malismf/iot_musorka/binsense/README.md

# BinSense — мониторинг заполненности мусорных контейнеров

Датчик на ESP8266 (NodeMCU) живёт под крышкой контейнера, измеряет уровень
мусора ультразвуком раз в 15 минут и отправляет данные по MQTT, когда уровень
изменился. Диспетчер видит контейнеры на карте, получает уведомления в
веб-приложении, когда пора вывозить, и может посмотреть историю
заполнения.
Питание — от USB (зарядка телефона 5 В), устройство работает постоянно.

```
  устройство (ESP8266 + УЗ-датчик)
        │ MQTT (QoS 1, retained-настройки)
        ▼
    Mosquitto ──► ingestor ──► PostgreSQL ──► Grafana (мониторинг разработчика)
                                    ▲
                                    │ SQL + LISTEN/NOTIFY
                                    ▼
                                  FastAPI ──REST/WebSocket──► веб-приложение (карта, события)
```

## Быстрый старт

```bash
git clone https://github.com/ВАША_КОМАНДА/binsense.git
cd binsense
./infra/scripts/init-env.sh bins.example.com admin@bins.example.com
docker compose up -d --build

# посмотреть, как всё работает, без единого устройства:
docker compose --profile demo up -d emulator
```

Откройте `https://bins.example.com` и войдите под администратором, пароль
напечатал `init-env.sh`. Подробная инструкция по развёртыванию —
[docs/DEPLOY.md](docs/DEPLOY.md), проверка на ноутбуке с настоящей платой по
Wi-Fi — [docs/LOCAL_TEST.md](docs/LOCAL_TEST.md).

## Документация

| Файл | О чём |
|---|---|
| [docs/DEPLOY.md](docs/DEPLOY.md) | развёртывание сервера с нуля, обновления, бэкапы, устранение неполадок |
| [docs/LOCAL_TEST.md](docs/LOCAL_TEST.md) | локальный стенд: сервер на ноутбуке, плата по Wi-Fi |
| [docs/ASSEMBLY.md](docs/ASSEMBLY.md) | сборка устройства своими руками: от макета до установки на контейнер |
| [docs/USER_GUIDE.md](docs/USER_GUIDE.md) | инструкции монтажнику, диспетчеру и водителю |
| [docs/FIRMWARE.md](docs/FIRMWARE.md) | устройство прошивки, консоль, энергопотребление |
| [docs/PROTOCOL.md](docs/PROTOCOL.md) | MQTT, REST, WebSocket, интерфейсы периферии |
| [docs/asyncapi.yaml](docs/asyncapi.yaml) | формальное описание MQTT-протокола (AsyncAPI) |
| [docs/openapi.json](docs/openapi.json) | схема REST API (живая версия — `/api/docs`) |
| [docs/TESTING.md](docs/TESTING.md) | тесты прошивки и сервера, проверка системы целиком |
| [docs/REQUIREMENTS.md](docs/REQUIREMENTS.md) | соответствие требованиям задания и разделение работы |
| [CLAUDE.md](CLAUDE.md) | краткий контекст проекта: решения, инварианты, соглашения (его же читает Claude Code) |
| [hardware/WIRING.md](hardware/WIRING.md) | схема подключения и пояснения к обвязке |
| [docs/MEDIA.md](docs/MEDIA.md) | что снять для отчёта: список кадров и сценарий видео |
| [docs/presentation/](docs/presentation/) | презентация: структура, тезисы, ожидаемые вопросы (слайды опубликованы отдельно) |

## Состав репозитория

```
binsense/
├── firmware/      прошивка ESP8266 (PlatformIO) + тесты логики на хосте
├── backend/       FastAPI, ingestor, миграции, тесты
├── frontend/      веб-приложение (React, Leaflet, Chart.js)
├── tools/         provision.py (подготовка устройств), emulator.py
├── infra/         docker-compose, Mosquitto, Caddy, Grafana, скрипты
├── hardware/      спецификация и схема подключения
└── docs/          документация, тезисы презентации, план съёмки
```

## Возможности

**Устройство**
- ультразвуковой датчик по UART, медиана из нескольких замеров;
- питание от USB: постоянная связь с брокером, настройки применяются сразу;
- отправка только при изменении уровня или по heartbeat;
- калибровка одной кнопкой, индикация светодиодом и зуммером;
- настройка Wi-Fi через портал, учётные данные — без перепрошивки.

**Сервер**
- у каждого устройства своя учётная запись MQTT и доступ только к своим топикам;
- правила: заполнен, срочно вывезти, вывезен, нет связи, сбой датчика;
- история телеметрии с агрегацией, журнал действий;
- Grafana с техническими метриками: потери, задержки, время подключения, RSSI.

**Приложение**
- карта с цветными метками и живыми обновлениями по WebSocket;
- карточка контейнера: график за сутки, события, настройки;
- лента событий: предупреждения всплывают на любой странице;
- добавление устройства по коду привязки (ссылкой или вручную) с выбором места на карте;
- один уровень доступа: любой пользователь — администратор.

## Разработка

```bash
# сервер и база в Docker, фронтенд отдельно с горячей перезагрузкой
docker compose -f docker-compose.yml -f docker-compose.dev.yml up -d --build
cd frontend && npm install && npm run dev

# тесты
cd backend && python -m pytest
cd firmware/hosttest && ./run.sh
```

Лицензия: MIT.
