malismf/iot_musorka/binsense/docs/REQUIREMENTS.md

# Соответствие требованиям задания

| № | Требование | Как закрыто | Где смотреть |
|---|---|---|---|
| 1 | Электрическая схема: принципиальная и монтажная, со всеми обвязочными элементами | **В работе:** схемы команда рисует сама по таблице распиновки и спецификации | `hardware/WIRING.md`, `hardware/BOM.csv` |
| 2 | Способы взаимодействия периферии и МК | UART (ультразвуковой датчик, программный), цифровой вход (кнопка), длительность импульса (HC-SR04), ШИМ (RGB-светодиод), цифровой выход через транзистор (зуммер), Wi-Fi | `docs/PROTOCOL.md` §4, `firmware/src/` |
| 3 | Взаимодействие модулей системы | MQTT между устройством и сервером, REST + WebSocket между сервером и приложением, PostgreSQL LISTEN/NOTIFY между сервисами | `docs/PROTOCOL.md`, `docs/asyncapi.yaml` |
| 4 | Модель корпуса, отдельные STL, схема расположения элементов | **Не закрыто:** 3D-модели корпуса в проекте нет, корпус — готовая герметичная коробка. Расположение деталей будет показано на монтажной схеме, которую рисует команда | `docs/ASSEMBLY.md` §7 |
| 5 | Описание проекта, презентация, репозиторий, документация API и протоколов | Репозиторий с документацией; OpenAPI генерируется автоматически, MQTT описан в AsyncAPI; презентация на 19 слайдов с тезисами и разбором ожидаемых вопросов | `README.md`, `docs/presentation/`, `docs/openapi.json`, `/api/docs`, `docs/asyncapi.yaml` |
| 6 | Первое включение, настройка, калибровка, регистрация (PlugAndPlay) | Портал Wi-Fi без прошивки, привязка по коду (ссылкой из `provision.py` или вводом вручную), калибровка одной кнопкой; «заводская» подготовка скриптом | `docs/USER_GUIDE.md`, `tools/provision.py`, `docs/LOCAL_TEST.md` |
| 7 | Сценарии использования с реакцией устройства на действия | Роли монтажника, диспетчера и водителя; таблица индикации: цвет светодиода и сигналы зуммера на каждое действие | `docs/USER_GUIDE.md`, `docs/FIRMWARE.md` (раздел «Индикация») |
| 8 | Приложение с картой, данными в реальном времени и историей | React-приложение: карта Leaflet с цветными метками, список, карточка с графиком за сутки, живые обновления по WebSocket | `frontend/` |
| 9 | Сервер обмена данными | Mosquitto с авторизацией и разграничением доступа по устройствам | `infra/mosquitto/`, `backend/app/mqtt.py` |
| 10 | Регистрация устройств, связь пользователя и устройства | Код привязки (хранится хешем), привязка по ссылке или вводом кода, блокировка перебора, удаление устройства | `backend/app/api/routes/devices.py`, `backend/app/devices.py` |
| 11 | База данных: история, пользователи, действия | PostgreSQL: `users`, `devices`, `device_config`, `telemetry`, `events`, `audit_log`, `device_metrics`, `api_requests` | `backend/migrations/001_init.sql` |
| 12 | (опционально) Сервер логов и мониторинга для разработчика | Grafana: доступность устройств, потери сообщений, задержка доставки, время подключения, RSSI, время ответа API, причины перезагрузок, часы простоя | `infra/grafana/`, `/grafana/` |
| 13 | Обратная связь, когда пользователь не рядом с устройством | Веб-приложение (открывается и с телефона): события приходят в реальном времени по WebSocket, предупреждения всплывают на любой странице, лента событий с кнопкой «Принято», повторное срочное событие, если заполненный контейнер не подтвердили за 2 часа | `frontend/src/lib/store.jsx`, `frontend/src/pages/EventsPage.jsx`, `backend/app/rules.py` |

## Разделение работы в команде

| Участник | Зона ответственности | Файлы |
|---|---|---|
| A — электроника и прошивка | схемы, сборка, пайка, прошивка, энергопотребление, заводская подготовка устройств | `firmware/`, `hardware/`, `tools/provision.py` |
| B — бэкенд | брокер, API, база, правила событий, развёртывание, эмулятор, Grafana | `backend/`, `infra/`, `tools/emulator.py` |
| C — дизайн и фронтенд | интерфейс, карта, фотографии, видео, презентация | `frontend/`, `docs/presentation/`, `docs/MEDIA.md` |

## Что осталось физически

Всё, что можно сделать без собранного устройства, сделано. Остаются работы,
которые требуют железа в руках:

- собрать устройство на реальной плате ESP8266 и проверить датчик на контейнере;
- отснять фотографии и видео по списку в `docs/MEDIA.md`;
- проверить сборку docker-образов на машине с доступом к реестру;
- пройти сквозную проверку на локальном стенде: сервер на ноутбуке, плата по
  Wi-Fi (`docs/LOCAL_TEST.md`).

## Что стоит показать в презентации как «путь проб»

- HC-SR04 на макете → влагозащищённый датчик по UART (питание 5 В, влага,
  ширина луча, другой протокол);
- ESP32 с аккумулятором и глубоким сном → ESP8266 (NodeMCU) с питанием от
  USB: такая плата была в наличии, а без батареи устройство работает
  постоянно — кнопка и настройки срабатывают сразу;
- PubSubClient → arduino-mqtt: понадобился QoS 1, чтобы устройство знало, что
  данные дошли;
- отправка каждые 15 минут → отправка по изменению: в базе только изменения;
- замер при открытой крышке → геркон на крышке → геркона в комплекте нет:
  резкий скачок уровня перепроверяется повторным замером через минуту;
- ArduinoJson → свой разбор JSON: меньше памяти и тесты логики гоняются на
  обычном компьютере, пока железо едет;
