malismf/iot_musorka/binsense/docs/presentation/README.md

# Презентация

Девятнадцать слайдов на защиту, примерно на 10–11 минут. Презентация
опубликована как отдельный документ и правится там же; здесь лежит её
содержание в текстовом виде — чтобы можно было готовиться без интернета,
пересобрать в PowerPoint или отдать другому докладчику.

Принципиальную и монтажную схемы команда рисует сама по `hardware/WIRING.md`.
Диаграмма архитектуры, цикл работы устройства и схема стенда для защиты
нарисованы прямо в слайдах.

Фотографии и видео добавляются по мере съёмки — сценарий в
[../MEDIA.md](../MEDIA.md).

---

## Структура

| № | Слайд | О чём | Что на экране |
|---|---|---|---|
| 1 | BinSense | название, одна фраза о проекте | три цифры: полгода от 18650, 107 тестов, 3 человека |
| 2 | Проблема | расписание промахивается в обе стороны | пустые рейсы / переполнение / нет данных |
| 3 | Решение | устройство молчит, пока нечего сказать | цикл из пяти шагов |
| 4 | Архитектура | пять сервисов и одна база | диаграмма обмена данными |
| 5 | Устройство | что внутри и почему именно так | таблица узлов + цифры по току |
| 6 | Принципиальная схема | вся обвязка | схема целиком |
| 7 | Решения в схеме | ключ, кнопка на RTC-выводе, ADC1 | три карточки |
| 8 | Монтажная схема | что куда паяется | схема шилда |
| 9 | Энергопотребление | откуда берётся полгода | таблица токов + расчёт |
| 10 | Протокол | рассчитан на спящее устройство | retained, QoS 1, без Last Will |
| 11 | Приложение | что видит диспетчер | шесть карточек |
| 12 | Telegram | обратная связь вне рабочего места | уведомления, кнопка, команды |
| 13 | Plug and Play | первое включение без компьютера | три шага |
| 14 | Стенд для защиты | всё на одном ноутбуке | схема «ESP32 → хот-спот → Docker → браузер» и три карточки |
| 15 | Мониторинг | что видит разработчик | таблица панелей Grafana |
| 16 | Путь проб | что выкинули и почему | таблица «было → стало → почему» |
| 17 | Состояние | что проверено, что нет | два столбца |
| 18 | Команда | роли и планы | шесть карточек |
| 19 | Финал | вывоз по факту, а не по расписанию | заключение |

---

## Тезисы докладчика

**1. BinSense.** Система мониторинга заполненности мусорных контейнеров.
Датчик на ESP32 живёт под крышкой контейнера и работает от одного
аккумулятора около полугода.

**2. Проблема.** Расписание не знает, что происходит во дворе. Отсюда две
ошибки сразу: лишние рейсы к пустым контейнерам и переполнение там, где людей
много.

**3. Решение.** Цикл устройства: проснуться по таймеру или кнопке, померить,
решить, нужно ли отправлять, отправить и уснуть. Отправка по изменению, а не
по таймеру, — главное решение по энергопотреблению. Резкий скачок уровня
плата сначала перемеряет через минуту: датчика крышки нет, и замер мог
попасть на открытую крышку.

**4. Архитектура.** Брокер, приёмник данных, база, API, бот и Grafana. Всё
поднимается одной командой `docker compose up`. Реальное время сделано без
Redis: ingestor делает `pg_notify`, API слушает канал и рассылает по WebSocket.

**5. Устройство.** Ключевые детали — плата с малым током сна и ключ питания
датчика. Без ключа датчик ест миллиамперы круглосуточно. Замер — медиана из
семи, скачок на 20 % и больше перепроверяется повторным замером.

**6. Принципиальная схема.** Вся обвязка на месте: подтяжки, делители, ключи,
конденсаторы. Схема генерируется из той же таблицы распиновки, что и
документация, — править нужно один список, а не три картинки.

**7. Решения в схеме.** Ключ питания датчика: в покое датчик ест несколько
миллиампер, в тысячи раз больше, чем ESP32 во сне. Кнопка на RTC-выводе
GPIO32 будит ESP32 из глубокого сна, 10 кОм и 100 нФ убирают дребезг.
Батарея на GPIO35: ADC2 не работает при включённом Wi-Fi.

**8. Монтажная схема.** По ней собирают, а не по принципиальной. Ключ Q1
и конденсатор C1 стоят рядом, чтобы питание датчика не проседало. Провода
датчика идут в клеммник: разъём Dupont в контейнере разбалтывается от
вибрации.

**9. Энергопотребление.** Цикл: пробуждение на 3 секунды при 120 мА — около
0.1 мА·ч; при интервале 15 минут примерно 10 мА·ч в сутки. Аккумулятор
2500 мА·ч даёт около полугода. С обычным DevKit та же батарея сядет за
две–три недели.

**10. Протокол.** Настройки — retained-сообщение: спящее устройство не примет
команду в произвольный момент. QoS 1 и дедупликация по устройству,
идентификатору включения и номеру пакета. Last Will не используется: для
спящего устройства брокер объявлял бы офлайн после каждого засыпания.

**11. Приложение.** Карта с цветными метками, карточка с графиками,
маршрут вывоза, привязка по коду.

**12. Telegram.** Уведомление в момент события и подтверждение одной кнопкой.
Это закрывает требование об обратной связи, когда пользователь не рядом с
устройством.

**13. Plug and Play.** Портал Wi-Fi без прошивки, привязка по коду (ссылка
из скрипта подготовки или ручной ввод), калибровка одной кнопкой. «Заводская»
подготовка — скриптом.

**14. Стенд для защиты.** Систему показываем целиком на одном ноутбуке:
он раздаёт плате Wi-Fi хот-спотом (адрес по умолчанию 192.168.137.1) и держит
весь сервер в Docker. provision.py прошивает плату, записывает адрес брокера
и выдаёт ссылку для привязки. Без интернета не будет только плиток карты и
Telegram. Инструкция — `docs/LOCAL_TEST.md`.

**15. Мониторинг.** Доступность, потери сообщений, задержка доставки, время
бодрствования, заряд, причины перезагрузок. Без этого не видно, что устройство
начало просыпаться чаще, чем должно.

**16. Путь проб.** Восемь строк — почти каждая стоила дня работы. Показываем
их специально: конечная конструкция без них выглядит как удача.

**17. Состояние.** Честно разделяем: прогнано на стенде — подготовка
устройства, привязка, телеметрия, события, уведомления, история,
маршрут, 38 тестов сервера и 51 проверка логики прошивки. Не проверено вживую
— сборка docker-образов, реальный ESP32 на стенде «ноутбук + Wi-Fi»,
реальный Telegram Bot API.

**18. Команда.** Роли разделены по каталогам репозитория, поэтому работа шла
параллельно. Дальше: устройство на реальной плате и стенд целиком, съёмка,
месяц на реальных контейнерах.

**19. Финал.** Вывоз по факту, а не по расписанию.

---

## Вопросы, которые зададут

| Вопрос | Короткий ответ |
|---|---|
| Почему не LoRaWAN или NB-IoT? | Wi-Fi во дворе есть у управляющей компании, а модуль дешевле и не требует оператора. Протокол вынесен в отдельный модуль прошивки: замена транспорта не трогает логику. |
| Что будет зимой? | Датчик влагозащищён, корпус герметичный, внутри силикагель. Ёмкость Li-ion на морозе падает — это честное ограничение, в Grafana видно по напряжению. |
| Как считается процент? | По расстоянию до мусора: пустой уровень задаётся калибровкой. Формула одна и та же в прошивке и на сервере — иначе устройство и карточка разойдутся. |
| Что, если мусор лежит горкой? | Ультразвук меряет ближайшую точку, поэтому процент завышается. Берём медиану нескольких замеров, а резкий скачок (например, крышку открыли во время замера) перепроверяем повторным замером через минуту. |
| Почему нет датчика крышки? | Геркона нет в комплекте. Устройство меряет по таймеру, а если замер попал на открытую крышку (рука или небо в луче), резкий скачок уровня перепроверяется повторным замером через минуту — случайное значение до сервера не доходит. |
| Почему привязка не по QR? | Печатать наклейки нам негде. Скрипт подготовки выдаёт ссылку с кодом: она открывает форму привязки с уже заполненными полями, код можно ввести и вручную. Код хранится хешем, перебор блокируется. |
| Что покажете вживую? | Всё на одном ноутбуке: хот-спот для платы, сервер в Docker, приложение в браузере. Домен и интернет не нужны. |
| Украдут? | В системе устройство привязано к учётной записи, удаление пишется в журнал. Сигнализацию не делали. |
| Сколько стоит устройство? | Смета — `hardware/BOM.csv`, 24 позиции; основные деньги — плата, датчик и аккумулятор. |
| Почему не KiCad? | Схема генерируется из той же таблицы распиновки, что и документация. Это исключает расхождение между схемой, прошивкой и описанием — при ручном проекте оно возникает на первой же правке пинов. |
