malismf/iot_musorka/binsense/docs/MEDIA.md

# Фото и видео: что снять и как

Съёмку делает человек с собранным устройством — заменить её нечем. Этот файл
закрывает подготовительную часть: что именно должно попасть в кадр, в каком
порядке и какой длины. По нему съёмка занимает один вечер вместо трёх
подходов.

Готовые материалы кладутся в `docs/media/` и подключаются в презентацию
(`docs/presentation/`) и в `README.md`.

---

## Оборудование

Телефон на штативе или стопке книг, настольная лампа с листом бумаги вместо
рассеивателя, лист серого или белого картона фоном. Съёмка с рук даёт дрожь,
которая на проекторе заметнее, чем на экране телефона.

Видео — 1080p 30 кадров, горизонтально. Вертикальное видео на защите
показывать неудобно.

---

## Фотографии

Список ниже — минимальный набор, который закрывает отчёт и презентацию.

| № | Кадр | Зачем | Как снимать |
|---|---|---|---|
| 1 | Компоненты, разложенные по местам | открывающий слайд, «из чего собрано» | вид сверху, фон-картон, подписи добавляются в презентации |
| 2 | Макет на breadboard с HC-SR04 | слайд «путь проб»: с чего начинали | общий план, видно провода и делитель Echo |
| 3 | Макетная плата с напаянной обвязкой, крупно | доказательство, что паяли сами | макро, фокус на резисторах и ключе зуммера |
| 4 | Плата в корпусе до закрытия крышки | компоновка и укладка проводов | сверху, при ровном свете |
| 5 | Устройство в сборе, три четверти | главное фото проекта | на сером фоне, свет сбоку |
| 6 | Устройство под крышкой контейнера | как ставится | с руками в кадре: масштаб понятнее |
| 7 | Устройство на контейнере, снизу | рабочее положение датчика | снизу вверх, видно головку датчика |
| 8 | Консоль платы: подключение к Wi-Fi и брокеру | видно, что устройство на связи | снимок экрана монитора порта |
| 9 | Страница «Добавить устройство» с заполненным кодом | привязка устройства | экран ноутбука или телефона; код привязки замажьте |
| 10 | Экран телефона с картой | приложение | снять экран, а не скриншот: видно, что это реальная система |
| 11 | Всплывающее предупреждение и лента событий в приложении | обратная связь | снять экран телефона |

Скриншоты интерфейса и Grafana делаются отдельно, в браузере: `Ctrl+Shift+S`
в Firefox снимает страницу целиком без обрезки.

---

## Видео: сценарий на 2:30

Один дубль на сцену, монтаж встык. Закадровый голос пишется отдельно и
кладётся поверх — синхронно говорить и снимать не получается.

| Время | Что в кадре | Закадровый текст |
|---|---|---|
| 0:00–0:12 | контейнер во дворе, крышка открывается | «Мусоровоз ездит по расписанию. Половина контейнеров пустые, часть переполнена ещё вчера.» |
| 0:12–0:25 | устройство в руках, потом на крышке | «Устройство измеряет уровень ультразвуком и работает от обычной USB-зарядки.» |
| 0:25–0:45 | подача питания, светодиод, портал Wi-Fi на телефоне | «Первое включение: устройство поднимает точку доступа, вводим сеть — прошивать ничего не нужно.» |
| 0:45–1:05 | ссылка для привязки, форма в приложении, карточка | «Привязка по коду: открываем ссылку, отмечаем место на карте — устройство появляется на карте.» |
| 1:05–1:25 | калибровка кнопкой: пустой контейнер, затем набросать мусор | «Калибровка одной кнопкой по пустому контейнеру. Дальше устройство считает процент само.» |
| 1:25–1:45 | заполнение контейнера, метка на карте меняет цвет | «Данные уходят по MQTT. Метка на карте меняет цвет по мере заполнения.» |
| 1:45–2:05 | предупреждение всплывает в приложении и появляется в ленте событий | «На 80 % приложение сразу показывает уведомление о заполненном контейнере.» |
| 2:05–2:20 | график истории в карточке | «История показывает, как заполнялся контейнер, — видно, когда его вывезли.» |
| 2:20–2:30 | общий план, логотип | «BinSense. Вывоз по факту, а не по расписанию.» |

Съёмочные хитрости:

- контейнер заполняется пустыми коробками — они лёгкие и не пачкают кадр;
- чтобы не ждать 15 минут между отправками, на время съёмки уменьшите
  `heartbeat_s` в настройках устройства через приложение;
- сцены 1:25–1:45 и 1:45–2:05 снимаются подряд одним заходом, иначе состояние
  системы придётся откатывать;
- телефон в кадре должен быть в режиме «не беспокоить»: чужие уведомления
  придётся вырезать.

---

## Схемы

Принципиальную и монтажную схемы команда рисует сама по `hardware/WIRING.md`.
Снимать их не нужно — в презентацию идут готовые рисунки.
