malismf/iot_musorka/BinSense.pptx

КУРСОВОЙ ПРОЕКТ · ИНТЕРНЕТ ВЕЩЕЙ

BinSense

Мусорные контейнеры сами сообщают, когда их пора вывозить

≈ 6 месяцев

работы от одного аккумулятора 18650

99 тестов

48 на сервере, 51 на логике прошивки

3 человека

электроника, сервер, интерфейс и корпус

Notes: Здравствуйте. Проект BinSense: система мониторинга заполненности мусорных контейнеров. Датчик на ESP32 живёт под крышкой контейнера и работает от одного аккумулятора около полугода.

## Slide 2

Вывоз по расписанию промахивается в обе стороны

Пустые рейсы

Мусоровоз объезжает контейнеры, до которых ещё неделя. Топливо и время водителя уходят впустую.

Переполнение

Контейнер во дворе с высокой проходимостью переполняется за два дня, а по графику его вывезут в пятницу.

Нет данных

Диспетчер не знает, что происходит во дворах, пока не позвонят жильцы. Планировать не на чем.

Проблема

2

Notes: Расписание не знает, что происходит во дворе. Отсюда две ошибки сразу: лишние рейсы и переполненные контейнеры.

## Slide 3

Устройство измеряет уровень и молчит, пока нечего сказать

Ультразвуковой датчик под крышкой контейнера меряет расстояние до мусора. Данные уходят по MQTT только когда заполненность изменилась заметно — это главная экономия батареи.

Интервал опроса и порог изменения задаются с сервера и меняются без перепрошивки.

Решение

3

Notes: Цикл устройства: проснуться, померить, решить, нужно ли отправлять, отправить и уснуть. Отправка по изменению, а не по таймеру, — главное решение по энергопотреблению.

## Slide 4

Архитектура: пять сервисов и одна база

Обновления в реальном времени сделаны без Redis: ingestor делает pg_notify, API слушает канал и рассылает по WebSocket.

Архитектура

4

Notes: Брокер, приёмник данных, база, API, бот и Grafana. Всё поднимается одной командой docker compose up.

## Slide 5

Что внутри устройства

Узел | Что стоит | Почему так
Мозг | LOLIN D32 | малый ток сна, зарядка и делитель на плате
Датчик | A02YYUW, UART | влагозащищённый, не боится конденсата
Питание | 18650 + ключ | датчик выключается на время сна
Крышка | геркон + магнит | замер только при закрытой крышке
Монтаж | кнопка и RGB | калибровка и индикация на месте
Связь | Wi-Fi, MQTT | QoS 1: устройство знает, что дошло

Ток во сне

20–150 мкА с выключенным датчиком. На обычном DevKit было бы 5–10 мА — та же батарея села бы за две недели.

Цикл отправки

Пробуждение на 3 секунды при 120 мА — около 0.1 мА·ч. При интервале 15 минут это примерно 10 мА·ч в сутки.

Устройство

5

Notes: Ключевая деталь — плата с малым током сна и ключ питания датчика. Без ключа датчик ест миллиамперы круглосуточно.

## Slide 6

Корпус описан кодом, а не нарисован мышью

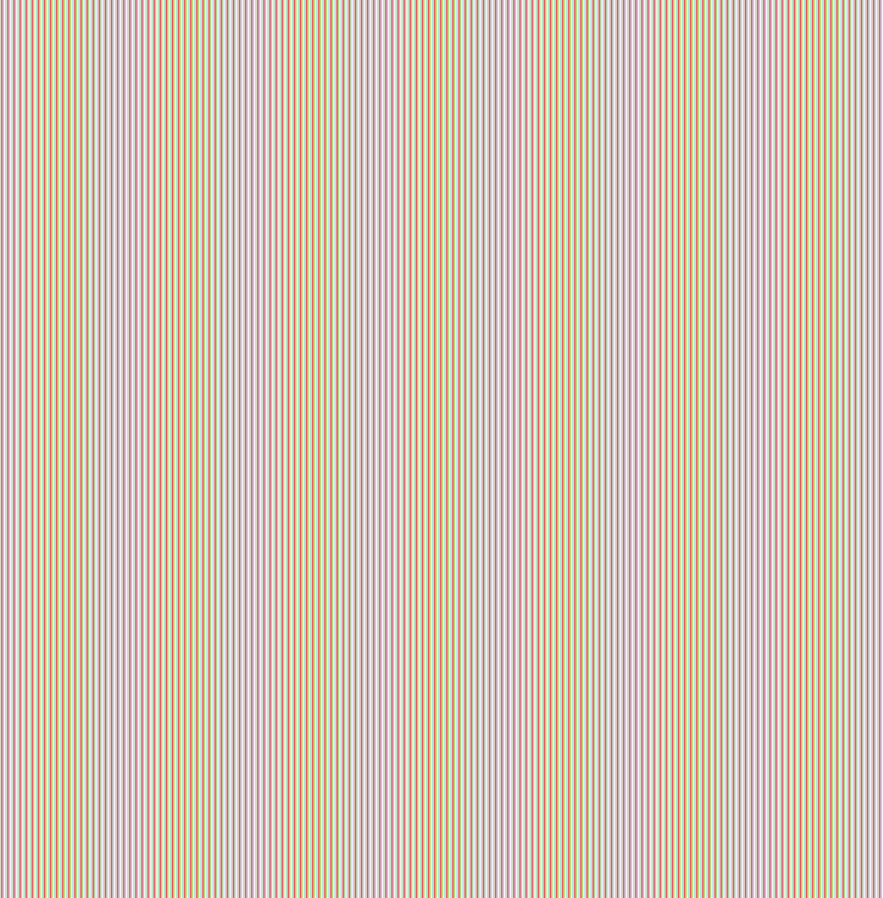
[picture p1: figure]
Чертёж расположения элементов внутри корпуса

Все размеры лежат в одном файле параметров. python build.py собирает девять STL и четыре чертежа, включая этот. Чертёж не может разойтись с моделью: он строится из тех же чисел.

Перед выгрузкой каждая деталь проверяется на замкнутость и целостность — деталь, распавшаяся на два куска, до принтера не доедет.

Пунктиром показан габарит колодок Dupont: провод с колодкой занимает больше места, чем кажется, и это частая причина переделки корпуса.

Корпус

6

Notes: Девять деталей: основание, крышка, уплотнитель, две вставки под датчик, кронштейн, держатель магнита, толкатель кнопки и световод.

## Slide 7

Три решения, которые видно только в разрезе

Винты снаружи уплотнителя

Шесть М3 идут по фланцу за пазом. Поставь винты внутри контура — вода пойдёт внутрь по резьбе, и уплотнитель потеряет смысл.

Паз — в основании, не в крышке

Так обе половины печатаются без поддержек: у основания паз открыт вверх, у крышки низ ровный. Шнур при сборке лежит сам.

Кнопка — в торцевой стенке

Крышка прижата кронштейном к крышке контейнера. Сверху до кнопки просто не дотянуться.

Корпус

7

Notes: Эти три вещи выяснились не сразу: первая версия была с винтами внутри контура и пазом в крышке.

## Slide 8

Принципиальная схема со всей обвязкой

Схемотехника

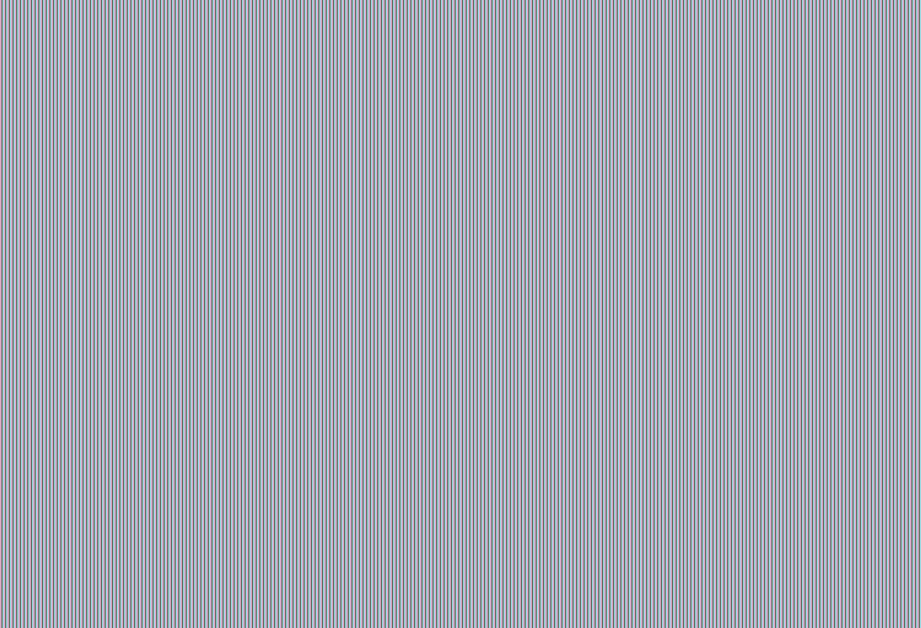
[picture p2: figure]
Принципиальная электрическая схема устройства

Схема генерируется из той же таблицы распиновки, что и документация: править нужно один список, а не три картинки.

Блоки соединены именами цепей, а не проводами через весь лист — так схема читается без линейки.

Второй лист — вариант прототипа на HC-SR04 с делителем Echo.

8

Notes: Вся обвязка на месте: подтяжки, делители, ключи, фильтрующие конденсаторы. Делитель батареи нарисован пунктиром — он уже распаян на плате.

## Slide 9

Три решения, за которые отвечает схема

Ключ питания датчика

Датчик в покое ест несколько миллиампер — в тысячи раз больше, чем ESP32 во сне. Резистор 10 кОм держит затвор у питания, пока выводы спящего ESP32 в высокоимпедансном состоянии.

Подтяжка геркона 1 МОм

Крышка почти всегда закрыта, геркон замкнут. Через 10 кОм тёк бы ток 330 мкА — больше, чем ест вся плата во сне. Через 1 МОм течёт 3.3 мкА.

Батарея на GPIO35

Напряжение меряется только выводами ADC1. ADC2 не работает, когда включён Wi-Fi, — на этом легко потерять день.

Схемотехника

9

Notes: Каждое из трёх решений экономит ток. Вместе они превращают две недели работы в полгода.

## Slide 10

Монтажная схема: что куда паяется

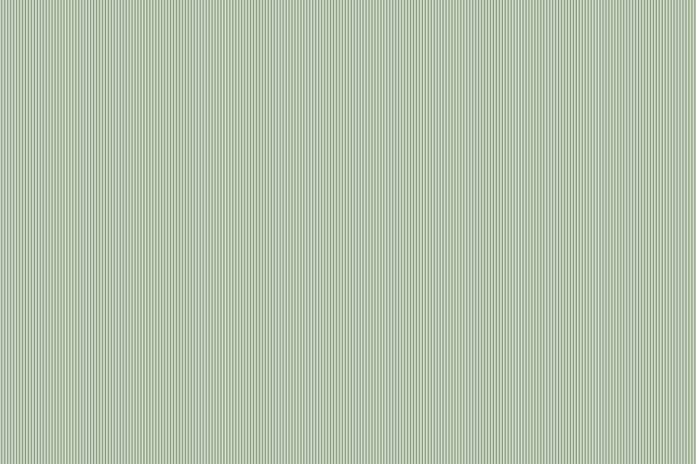
[picture p3: figure]
Монтажная схема шилда и проводов к плате

Обвязка собрана на макетной плате 40 × 60 мм, которая надевается на гребёнки ESP32. Плату можно снять и заменить, не распаивая обвязку.

Геркон паяется последним: стеклянную колбу легко расколоть пинцетом.

Провода датчика идут в клеммник, а не в разъём Dupont: в контейнере разъём разбалтывается от вибрации при выгрузке.

Сборка

10

Notes: Монтажная схема нужна не меньше принципиальной: по ней собирают, а не по принципиальной.

## Slide 11

Откуда берётся полгода работы

Режим | LOLIN D32 | ESP32 DevKit v1
Глубокий сон, датчик выключен | 20–150 мкА | 5–10 мА
Измерение, датчик включён | 40–60 мА | 40–60 мА
Передача по Wi-Fi | 120–180 мА | 120–180 мА

Цикл: пробуждение на 3 секунды при 120 мА — около 0.1 мА·ч. При интервале 15 минут выходит примерно 10 мА·ч в сутки. Аккумулятор 2500 мА·ч с учётом саморазряда даёт около полугода.

Выбор платы решает всё

С обычным DevKit тот же аккумулятор сядет за две–три недели. Разница — только в токе сна.

Отправка по изменению

Порог delta_pct и период heartbeat_s задаются с сервера: можно подстроить под конкретный двор, не перепрошивая устройство.

Энергопотребление

11

Notes: Цифры замерены мультиметром в разрыве провода от аккумулятора.

## Slide 12

Протокол рассчитан на спящее устройство

Настройки — retained-сообщение

Команду в произвольный момент спящее устройство не примет. Оно просыпается, подписывается и получает последнюю версию настроек. Версия возвращается в телеметрии — сервер видит, что настройки применены.

QoS 1 и дедупликация

Уникальный индекс по устройству, идентификатору включения и номеру пакета. Разрывы номеров дают метрику потерь, а перезагрузка не путается с потерей связи.

Last Will не используется

Для спящего устройства брокер объявлял бы офлайн после каждого засыпания. Статус «нет связи» считает сервер по времени последнего пакета и периоду опроса.

Протокол описан формально: MQTT — в AsyncAPI, REST — в OpenAPI, живая версия на /api/docs.

Протокол

12

Notes: Три решения, которые отличают протокол для спящего устройства от обычного MQTT-клиента.

## Slide 13

Приложение диспетчера

Карта

Метки меняют цвет по заполненности. Обновления приходят по WebSocket — страницу перезагружать не нужно.

Карточка контейнера

Графики за сутки, неделю и месяц, история событий, прогноз заполнения и кнопка «вывезли».

Маршрут

Контейнеры выше порога собираются в маршрут и открываются в картах одной ссылкой.

Привязка по QR

Сканер в браузере читает код с наклейки. Есть ручной ввод: сканер требует HTTPS.

Роли

Монтажник, диспетчер, водитель и администратор видят разное и получают разные уведомления.

Журнал действий

Все действия пользователей пишутся в audit_log: кто отвязал устройство и когда.

Интерфейс

13

Notes: React, Leaflet и Chart.js. Состояние приложения — в одном месте, сетевые вызовы — через один модуль.

## Slide 14

Обратная связь, когда диспетчер не за компьютером

Телеграм-бот отправляет уведомление в момент события и принимает подтверждение одной кнопкой. Это закрывает требование об обратной связи, когда пользователь не рядом с устройством.

Уведомления

Заполнен на 80 %, переполнен, нет связи, разряжена батарея, крышка открыта долго. Каждому событию — свой получатель.

Кнопка «Принято»

Подтверждение пишется в базу: видно, кто и когда принял событие в работу.

Команды

Статус контейнера, список переполненных, последние события и маршрут вывоза ссылкой на карты.

Уведомления

14

Notes: Бот сделан на aiogram. Правила, по которым рождаются события, — чистые функции, покрытые тестами.

## Slide 15

Первое включение без компьютера

1 · Wi-Fi без прошивки

Устройство поднимает точку доступа и показывает портал. Монтажник вводит сеть с телефона — паять и прошивать ничего не нужно.

2 · Привязка по QR

На корпусе наклейка с кодом. Код хранится хешем, перебор блокируется. Устройство появляется на карте сразу после сканирования.

3 · Калибровка кнопкой

Одно нажатие на пустом контейнере задаёт нулевой уровень. Светодиод и зуммер подтверждают, что замер принят.

«Заводская» подготовка устройств делается скриптом: он прошивает, заводит учётную запись в брокере и печатает наклейку с QR-кодом.

Plug and Play

15

Notes: Сценарий проверен на стенде целиком: от подготовки устройства до первой телеметрии на карте.

## Slide 16

Что видит разработчик, а не диспетчер

Панель | Зачем
Доступность устройств | кто перестал выходить на связь
Потери сообщений | разрывы номеров пакетов
Задержка доставки | сколько шло от датчика до базы
Время бодрствования | растёт — батарея сядет раньше срока
Уровень сигнала и заряд | где Wi-Fi на пределе
Причины перезагрузок | паника прошивки видна сразу

Дашборд генерируется

JSON дашборда собирает скрипт: руками его не правят, иначе изменения теряются при следующем обновлении.

Эмулятор

Двенадцать виртуальных контейнеров поднимаются одной командой — систему можно показать без единого железного устройства.

Мониторинг

16

Notes: Это необязательный пункт задания, но без него не видно, что устройство начало просыпаться чаще, чем должно.

## Slide 17

Путь проб: что выкинули и почему

Было | Стало | Почему
HC-SR04 на макете | A02YYUW по UART | влага, 5 В и ширина луча; UART вместо длительности импульса
Плата DevKit v1 | LOLIN D32 | ток сна 5–10 мА против 20–150 мкА: разница в разы по сроку
PubSubClient | arduino-mqtt | нужен QoS 1: устройство должно знать, что данные дошли
Last Will | расчёт статуса на сервере | для спящего устройства брокер объявлял бы офлайн каждый час
Отправка каждые 15 минут | отправка по изменению | главная экономия батареи
Замер при открытой крышке | ожидание закрытия по геркону | рука или мешок в луче давали ложные 100 %
ArduinoJson | свой разбор JSON | меньше памяти, а логика тестируется на обычном компьютере
Винты внутри уплотнителя | винты по фланцу снаружи | вода шла внутрь по резьбе

Пробы и ошибки

17

Notes: Почти каждая строка здесь — это день работы. Показываю их специально: конечная конструкция без них выглядит как удача.

## Slide 18

Что работает, а что ещё нет

Проверено на стенде

- подготовка устройства, привязка по QR, калибровка
- телеметрия, события, уведомления, подтверждение
- история, прогноз, маршрут, метрики
- 48 тестов сервера и 51 проверка логики прошивки
- сборка обоих вариантов прошивки и фронтенда

Состояние

Ещё не проверено вживую

- сборка docker-образов: в песочнице был закрыт реестр
- работа на реальном ESP32
- реальный Telegram Bot API — использовалась заглушка
- печать корпуса и посадка вставки датчика
- фотографии и видео собранного устройства

18

Notes: Честно разделяю: что прогнано на стенде и что осталось. Корпус смоделирован и проверен геометрически, но ещё не напечатан.

## Slide 19

Кто что делал и что дальше

Электроника и прошивка

Схемы, пайка, прошивка, энергопотребление, заводская подготовка устройств.

Сервер

Брокер, API, база, правила уведомлений, бот, развёртывание, эмулятор и мониторинг.

Дизайн и интерфейс

Корпус и CAD, веб-приложение, карта, фотографии, видео и эта презентация.

Дальше: печать

Напечатать тестовую пластину, уточнить посадку датчика, затем корпус целиком.

Дальше: съёмка

Тринадцать кадров и видео на две с половиной минуты — сценарий готов, нужны собранное устройство и контейнер.

Дальше: поле

Поставить два устройства на реальные контейнеры и прожить месяц на батарее.

Команда

19

Notes: Роли разделены по каталогам репозитория, поэтому работа шла параллельно и без конфликтов.

## Slide 20

Вывоз по факту, а не по расписанию

Репозиторий с прошивкой, сервером, приложением, схемами и моделями корпуса. Документация — от развёртывания до сборки устройства своими руками.

Спасибо. Готовы ответить на вопросы.

Notes: Спасибо за внимание.
