malismf/iot_musorka/binsense/cad/stl/body.stl

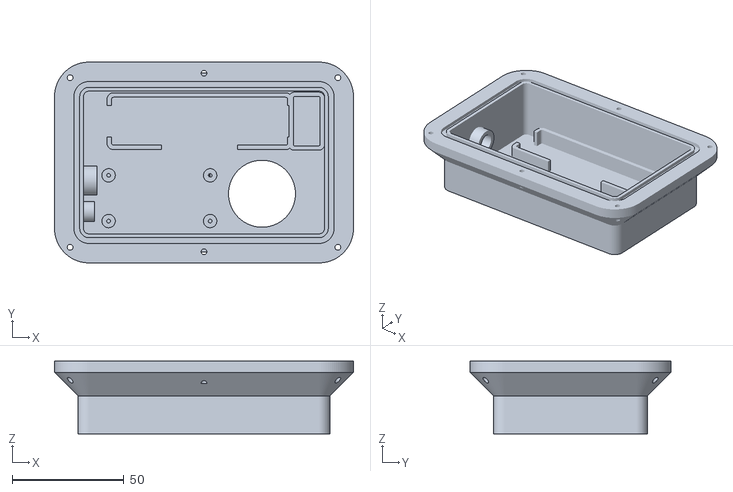
[picture p4: CAD file, 2026-09-27, last stored version]
binsense/cad/stl/body.stl
134.0 x 90.0 x 32.5
