malismf/iot_musorka/binsense/cad/stl/bracket.stl

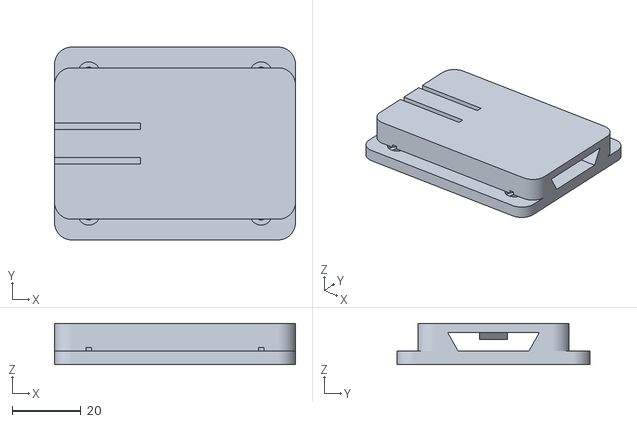
[picture p5: CAD file, 2026-09-27, last stored version]
binsense/cad/stl/bracket.stl
70.0 x 56.0 x 12.0
