malismf/iot_musorka/binsense/cad/stl/light_pipe.stl

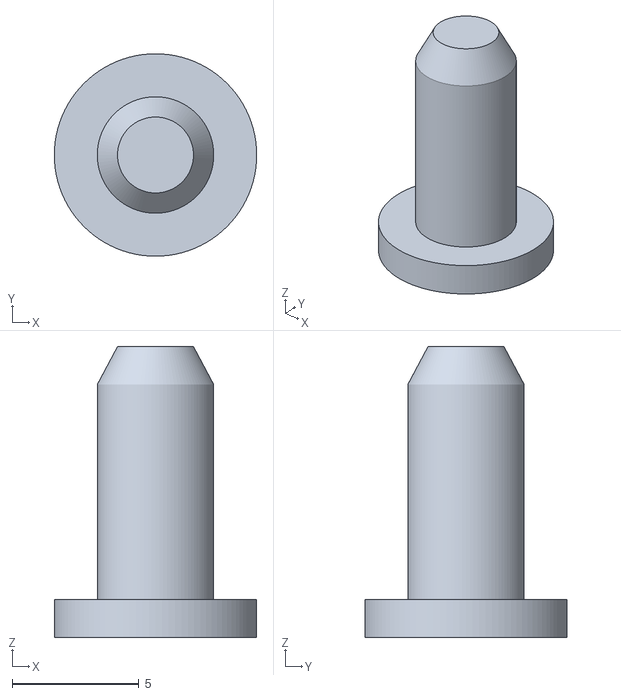
[picture p6: CAD file, 2026-09-27, last stored version]
binsense/cad/stl/light_pipe.stl
8.00 x 8.00 x 11.5
