malismf/iot_musorka/binsense/cad/stl/cover.stl

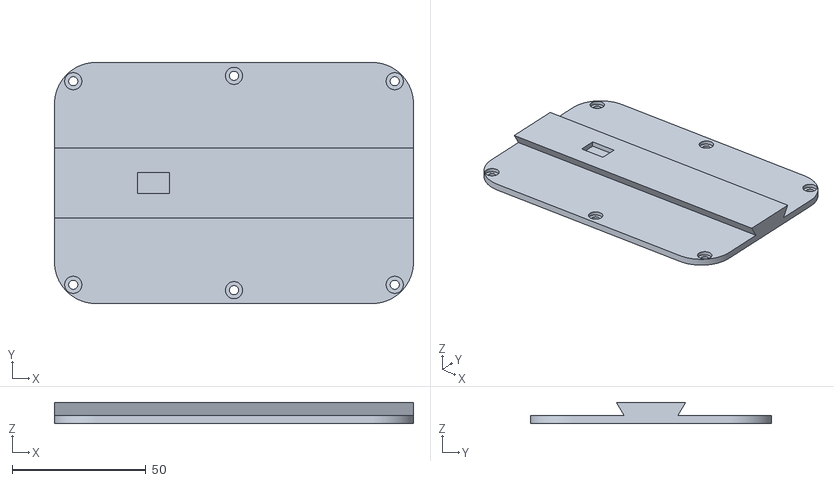
[picture p7: CAD file, 2026-09-27, last stored version]
binsense/cad/stl/cover.stl
134.0 x 90.0 x 8.00
