malismf/iot_musorka/binsense/cad/stl/gasket.stl

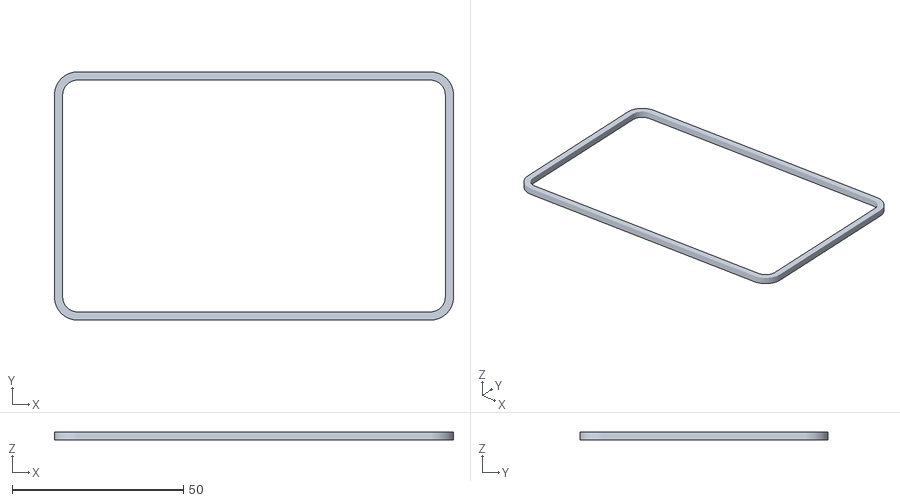
[picture p8: CAD file, 2026-09-27, last stored version]
binsense/cad/stl/gasket.stl
116.4 x 72.4 x 2.40
