malismf/iot_musorka/binsense/cad/stl/sensor_insert_a02yyuw.stl

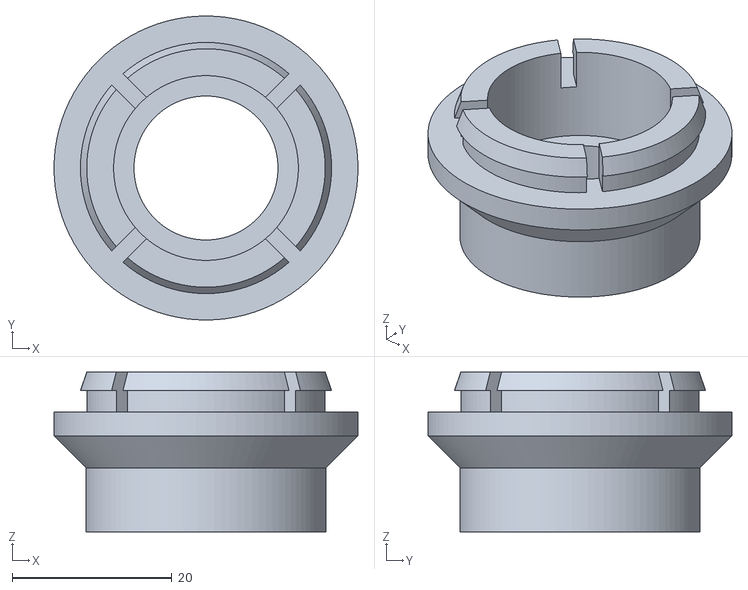
[picture p9: CAD file, 2026-09-27, last stored version]
binsense/cad/stl/sensor_insert_a02yyuw.stl
38.0 x 38.0 x 20.0
