malismf/iot_musorka/binsense/cad/stl/button_cap.stl

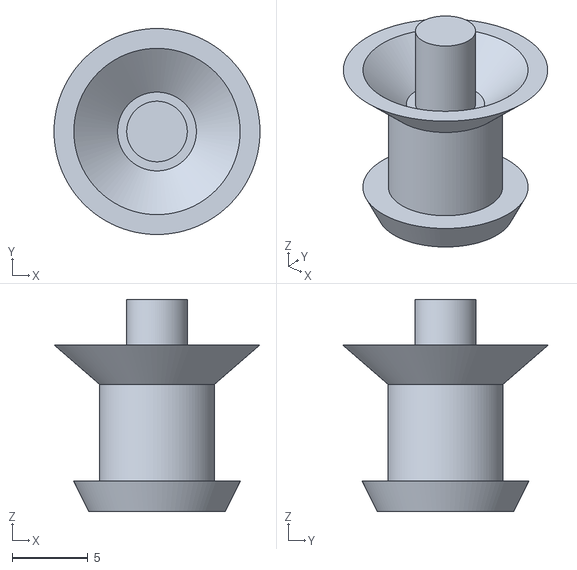
[picture p10: CAD file, 2026-09-27, last stored version]
binsense/cad/stl/button_cap.stl
13.6 x 13.6 x 14.0
