malismf/iot_musorka/binsense/cad/stl/sensor_insert_hcsr04.stl

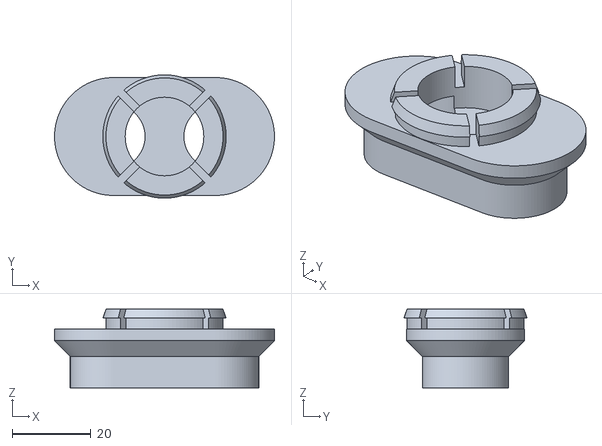
[picture p11: CAD file, 2026-09-27, last stored version]
binsense/cad/stl/sensor_insert_hcsr04.stl
56.0 x 31.4 x 20.0
