malismf/iot_musorka/binsense/docs/USER_GUIDE.md

# Инструкция пользователя

Три коротких раздела: для монтажника, для диспетчера и для водителя.
Печатать удобно первый — его достаточно, чтобы поставить устройство на
контейнер.

---

## Монтажнику: установка за пять шагов

**Что в комплекте:** устройство, зарядка USB 5 В с кабелем, идентификатор
устройства и код привязки (их выдаёт администратор после подготовки
устройства, например ссылкой для привязки).

### 1. Включите устройство

Подключите зарядку USB к розетке и к устройству. Светодиод **мигает синим** —
устройство ждёт настройки Wi-Fi.

### 2. Настройте Wi-Fi

На телефоне подключитесь к сети **BinSense-a1b2c3** (последние символы
совпадают с идентификатором устройства). Откроется страница настройки; если
нет — зайдите на `http://192.168.4.1`. Выберите сеть, введите пароль, нажмите
«Сохранить».

| Светодиод | Что происходит |
|---|---|
| мигает жёлтым | подключается |
| зелёный | подключился |
| мигает красным | пароль не подошёл, точка доступа откроется снова |

### 3. Привяжите устройство к аккаунту

Откройте ссылку для привязки, которую дал администратор, — откроется
приложение с уже заполненными идентификатором и кодом. Если ссылки нет,
в приложении откройте пункт меню «Добавить» и введите идентификатор и код
вручную. Войдите под своей учётной записью и заполните:

- название площадки (например, «Площадка №12»);
- адрес;
- место на карте — оно подставится по геолокации телефона, при необходимости
  подвиньте метку.

Нажмите «Привязать». Устройство **мигнёт зелёным три раза и дважды пискнет** —
значит, оно получило подтверждение от сервера.

### 4. Закрепите и откалибруйте

1. Закрепите устройство под крышкой **пустого** контейнера датчиком вниз.
2. Удерживайте кнопку 3 секунды — светодиод станет фиолетовым.
3. Закройте крышку в течение 5 секунд. Устройство сделает серию замеров и
   **мигнёт зелёным три раза**.

В приложении в карточке появится глубина контейнера — калибровка выполнена.

### 5. Проверьте

Коротко нажмите кнопку: светодиод покажет текущую заполненность
(зелёный — меньше половины, жёлтый — больше половины, красный — пора вывозить)
и устройство отправит данные. Убедитесь, что в приложении обновилось время
последних данных.

### Если что-то пошло не так

| Признак | Что делать |
|---|---|
| Светодиод не загорается | проверьте зарядку и кабель USB |
| Не появляется точка доступа BinSense | удерживайте кнопку 10 секунд (сброс настроек) |
| Три красные вспышки при нажатии кнопки | нет связи или датчик не отвечает: проверьте Wi-Fi в этом месте |
| Мигает бирюзовым | ждёт привязки в приложении — выполните шаг 3 |
| Калибровка не сохраняется | крышку не закрыли за 5 секунд или датчик направлен не вниз |

**Перенос на другой контейнер:** закрепите устройство на новом месте, в
настройках карточки поменяйте название, адрес и место на карте, затем
заново откалибруйте (шаг 4). История при этом сохраняется.

---

## Диспетчеру: ежедневная работа

**Карта.** Цвет метки — заполненность: зелёный меньше 50 %, жёлтый 50–80 %,
красный — пора вывозить. Серый — нет связи.
Клик по метке открывает карточку.

**Список.** Сортировка по заполненности, времени последних данных, состоянию;
поиск по названию и адресу. Кнопка «Удалить» стирает контейнер вместе с
историей и событиями; плата после этого не подключится, пока её заново не
подготовят через `provision.py`.

**Карточка контейнера.** Текущая заполненность, история за сутки, журнал
событий и
настройки: название, место, пороги, интервалы, глубина контейнера.

Изменённые настройки уходят устройству сразу и применяются, как только оно
их получит. Пока устройство не подтвердило их, в карточке висит отметка
«ожидают применения» — так видно, дошла ли команда.

**События.** Лента всех событий; кнопка «Очистить события» удаляет их все
(после подтверждения). Фильтр «Контейнер заполнен» оставляет только
заполненные контейнеры.

**Уведомления.** Пока приложение открыто (на компьютере или телефоне), новые
предупреждения всплывают поверх любой страницы и попадают в ленту событий:

| Событие | Когда |
|---|---|
| Контейнер заполнен | заполненность достигла порога (по умолчанию 80 %) |
| Контейнер вывезен | уровень упал с 50 % и выше до 15 % и ниже |
| Нет связи | данных нет дольше полутора интервалов heartbeat |

Информационные события (вывоз, калибровка) не всплывают, но видны в ленте.

---

## Водителю

Откройте приложение с телефона:

- «Список» с сортировкой по заполненности — какие контейнеры пора вывозить и
  их адреса;
- карта — заполненные контейнеры видны по цвету метки.

После вывоза ничего отмечать не нужно: устройство само увидит, что контейнер
опустел, и закроет событие. В приложении появится запись «Контейнер вывезен».
