malismf/iot_musorka/binsense/hardware/WIRING.md

# Схема подключения

Плата — ESP8266 NodeMCU v2/v3 или Wemos D1 mini: чип один и тот же, выводы
подписаны одинаково (D1…D8), прошивка общая. Питание — от USB.

Пины задаются в `firmware/include/config.h` и переопределяются в
`firmware/platformio.ini` флагами `-DPIN_...`, так что под другую раскладку
ничего править в коде не нужно.

## Основная сборка (NodeMCU + A02YYUW)

| Сигнал | Вывод (GPIO) | Куда идёт | Что дополнительно ставится |
|---|---|---|---|
| Датчик, приём данных | D5 (14) | белый провод A02YYUW (TX) | — |
| Датчик, выбор режима | D6 (12) | жёлтый провод A02YYUW (RX) | ничего: высокий уровень = усреднённые данные |
| Питание датчика | 3V3, G | красный и чёрный провода | — |
| Кнопка | D3 (0) | кнопка на землю | на NodeMCU — встроенная FLASH; подтяжка уже на плате |
| Светодиод R / G / B | D1 / D2 / D7 (5 / 4 / 13) | аноды RGB-светодиода | по 220 Ом на каждый канал, общий катод на землю |
| Зуммер | D8 (15) | база S8050 через 1 кОм | коллектор — зуммер, эмиттер — земля |

Питание: зарядка телефона 5 В, 1 А → разъём micro-USB платы (стабилизатор
3.3 В стоит на плате).

## Почему именно так

**Питание от USB, без аккумулятора.** Устройство работает постоянно и держит
связь с сервером: настройки применяются сразу, кнопка работает в любой момент.
Батарея не нужна, поэтому нет ни ключа питания датчика, ни замера заряда.

**Датчик от 3.3 В.** A02YYUW работает от 3.3 до 5 В. При 5 В его выход TX
выдавал бы 5 В на вход ESP8266, который рассчитан на 3.3 В.

**Программный UART на D5/D6.** У ESP8266 один полноценный UART, и он занят
консолью USB: через неё работают прошивка и `provision.py`. Датчик шлёт 9600
бод — программный UART с этим справляется.

**Выводы загрузчика.** D3 (GPIO0), D4 (GPIO2) и D8 (GPIO15) задают режим
загрузки: при включении D3 и D4 должны быть в высоком уровне, D8 — в низком.
Поэтому кнопка стоит на D3 (её не держат при включении, подтяжка к питанию уже
на плате), зуммер — на D8 через ключ (база притянута к земле), а D4 не занят.
Конденсатор от дребезга на кнопку не ставится: при включении он на миг
притянул бы D3 к земле. Дребезг гасит прошивка.

## Вариант с HC-SR04

| Сигнал | Вывод (GPIO) | Дополнительно |
|---|---|---|
| Trig | D5 (14) | — |
| Echo | D6 (12) | делитель 1 кОм / 2 кОм: датчик питается от 5 В, а ESP8266 не терпит 5 В на входе |
| VCC | VIN (на NodeMCU v3 — VU) | 5 В от USB |

Собирается окружением `pio run -e esp8266_hcsr04`. HC-SR04 от влаги не
защищён: для стенда годится, для установки на контейнер лучше A02YYUW.

## Потребление

| Режим | Ток от USB |
|---|---|
| Подключено к Wi-Fi, ожидание | 70–80 мА |
| Замер и передача | до 150–200 мА в пике |

Хватит любой зарядки телефона на 5 В и 1 А.
