malismf/iot_musorka/(commit log)

2026-09-27 Change ESP32 to ESP8266
    [body.stl, bracket.stl, button_cap.stl, cover.stl, gasket.stl, light_pipe.stl, sensor_insert_a02yyuw.stl, sensor_insert_hcsr04.stl]
2026-09-27 Remove night mode, urgent events and Telegram bot
    Remove night-mode, timezone and volume fields across stack; drop forecast and "full_urgent" escalation and Telegram bot/notify code. Add DB migrations (005/006) to clean columns and events. Backend: prune APIs/schemas/routes/tests and ingestor urgent checks; update config defaults (map center → Irkutsk). Firmware: remove TZ/night logic, reserve flash layout fields and add static_assert, simplify NetLink/NTP to UTC, adjust JSON reader. Frontend: add lucide-react icons, favicon, EventIcon, UI tweaks (no ack button, role-based claim), map defaults, styles. Update docs and deps (paho-mqtt, lucide-react).
    [netlist.csv]
2026-09-27 Single-role access and cleanup flow
    Remove per-role permissions in favor of a single admin-level user model. This updates JWT/auth flow, admin API routes, and schemas, and deletes role-specific UI and documentation. It also adds device deletion and event clearing flows, removes unclaim support, limits device history to the daily graph, and updates the protocols and docs to match. The patch includes the 007_single_role migration and a serial console helper to bypass FTDI driver noise on COM ports.
    [console.py]
